gregorywitt/mothsmoke-rpn1/rpn1 photo.jpg

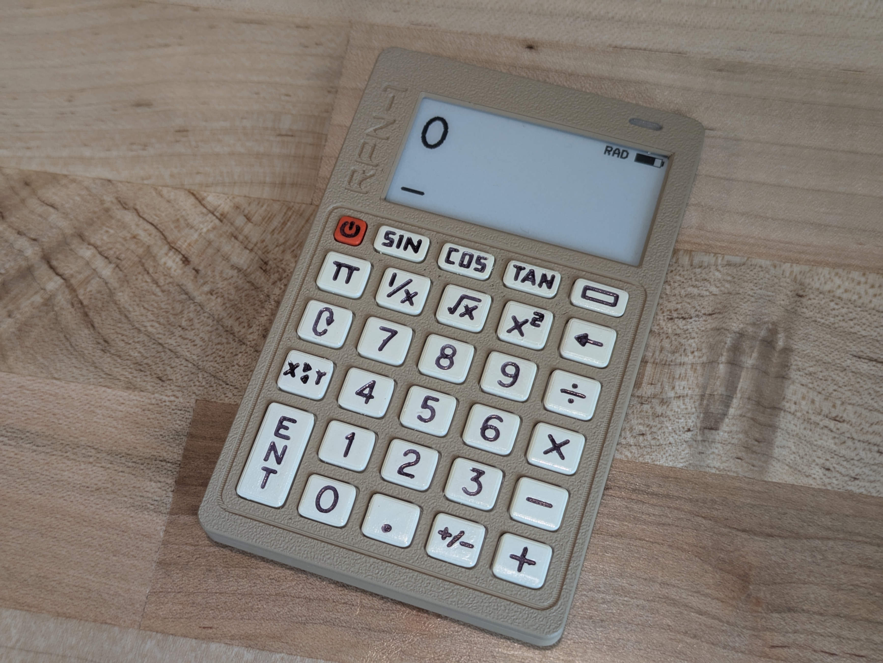
rpn1 photo.jpg
