gregorywitt/mothsmoke-rpn1/PCB/rpn1 schematic.pdf

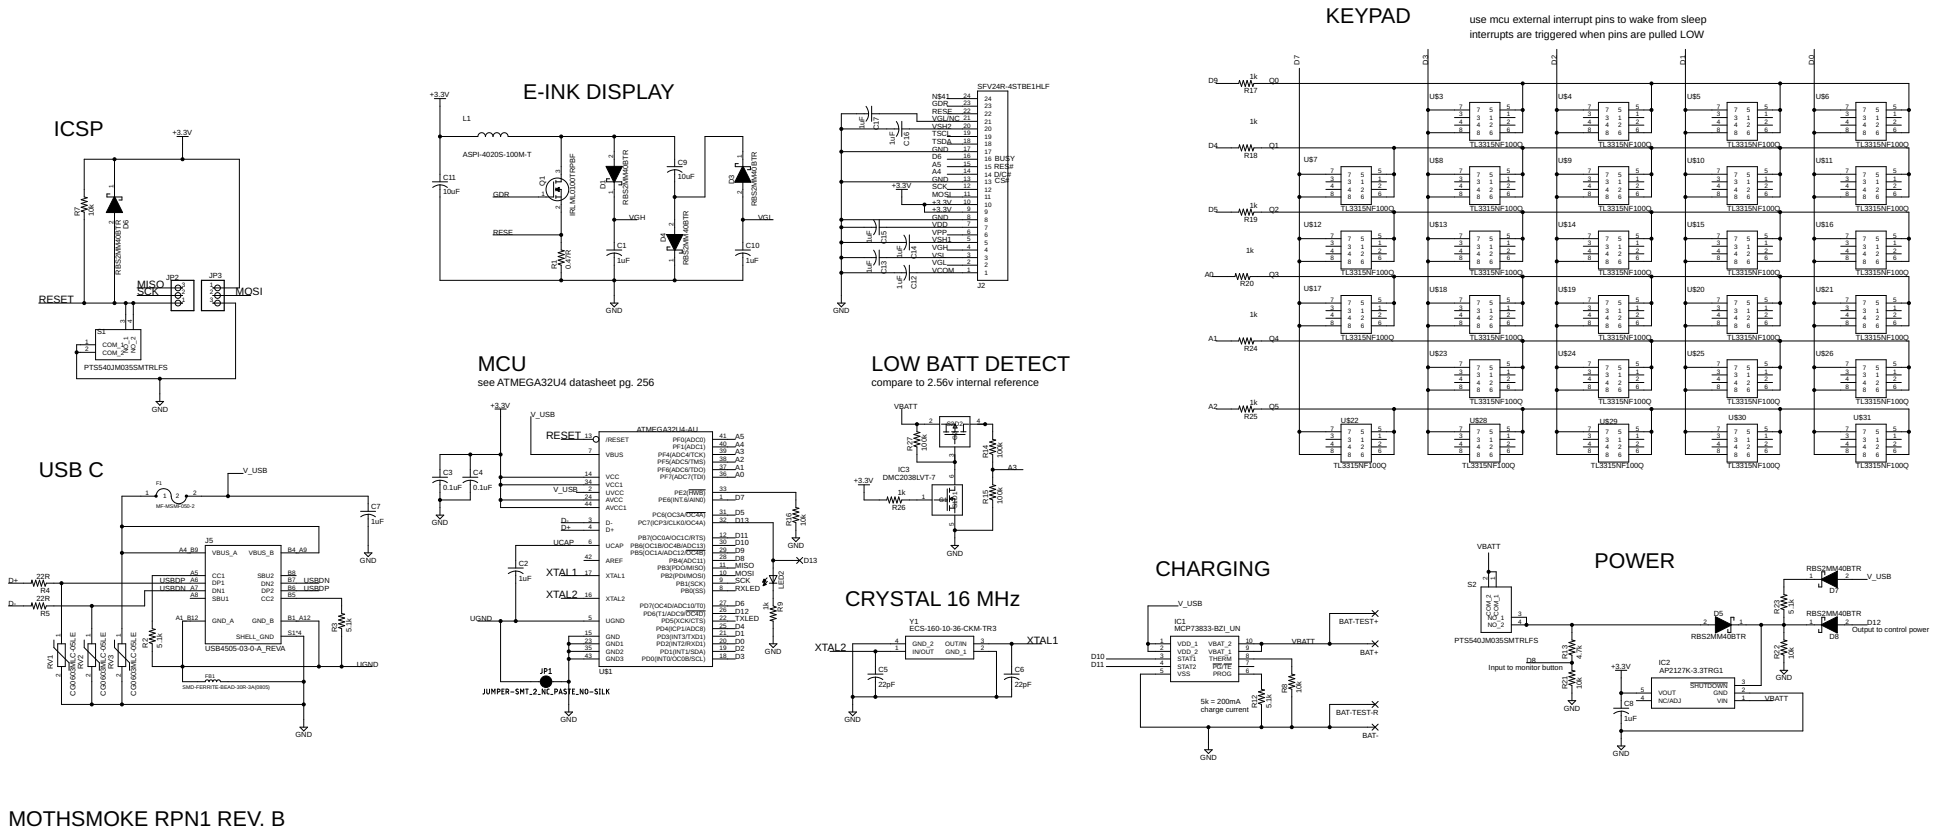
[picture p2: page 1]

use mcu external interrupt pins to wake from sleep
interrupts are triggered when pins are pulled LOW

compare to 2.56v internal reference

Output to control power

Input to monitor button
