gregorywitt/mothsmoke-rpn1/(commit log)

2025-08-15 stack rotation logic fixed
    [keypad.ino, operations.ino, rpn1.ino]
2025-08-17 pcb bom update
    [PCB BOM.csv]
